zmurtishi/Smart_Step_Counter/README.md

# Smart_Step_Counter
My M.S. project at the University of Rhode Island
